traxrobotics/medicine-bottle-monitor/docs/rev2_board_back.jpg

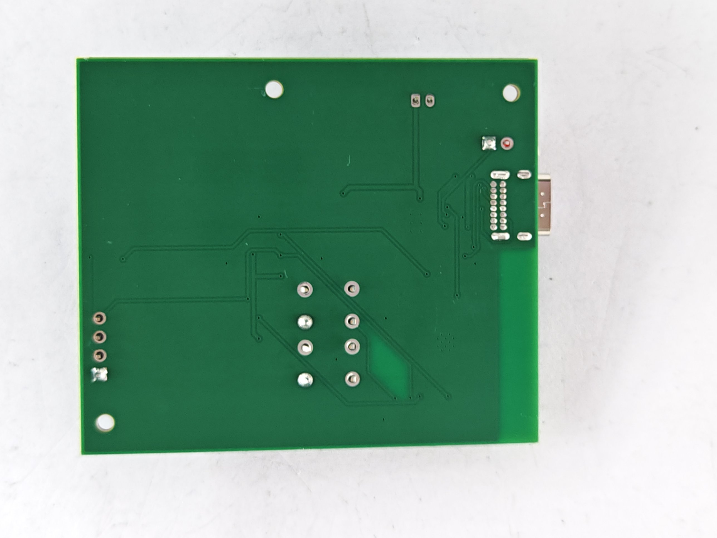
docs/rev2_board_back.jpg
