traxrobotics/medicine-bottle-monitor/hardware/bom/MedicineStorage_BOM.csv

Designator | Qty | Value | Footprint | LCSC | Description | MPN | # | Manufacturer
BT2 | 1 | CR1220 holder | Battery:BatteryHolder_Keystone_3000_1x12mm |  | Single-cell battery |  | 1
C1-C2 | 2 | 10uF, 16V, X5R | Capacitor_SMD:C_0805_2012Metric |  | Unpolarized capacitor |  | 2
C3 | 1 | 1uF, 16V, X7R | Capacitor_SMD:C_0805_2012Metric |  | Unpolarized capacitor |  | 3
C4-C5-C6-C7 | 4 | 0.1uF, 16V, X7R | Capacitor_SMD:C_0805_2012Metric |  | Unpolarized capacitor |  | 4
C8 | 1 | 10uF, 16V, X5R | Capacitor_SMD:C_0805_2012Metric |  | TP4056 VCC input cap |  | 5
C9 | 1 | 1uF, 16V, X7R | Capacitor_SMD:C_0805_2012Metric |  | EN RC delay cap |  | 6
C10 | 1 | 0.1uF, 16V, X7R | Capacitor_SMD:C_0805_2012Metric |  | DW01A VCC filter cap |  | 7
C11 | 1 | 0.1uF, 16V, X7R | Capacitor_SMD:C_0805_2012Metric |  | DRV5032 VCC decoupling |  | 8
C12 | 1 | 1uF, 16V, X7R | Capacitor_SMD:C_0805_2012Metric |  | AP2112K input cap on VSYS |  | 9
C13 | 1 | 1uF, 16V, X7R | Capacitor_SMD:C_0805_2012Metric |  | ADXL343 VS decoupling (place at pin 6) |  | 10
D1 | 1 | LED (CHRG) | LED_THT:LED_D5.0mm |  | Light emitting diode |  | 11
D2 | 1 | SS14 | Diode_SMD:D_SMA |  | Schottky, VBUS to system rail |  | 12
H1-H2-H3 | 3 | M2 hole | MountingHole:MountingHole_2.2mm_M2 |  | M2 mounting hole, 2.2 mm |  | 13
J1 | 1 | USB-C 2.0 | Connector_USB:USB_C_Receptacle_GCT_USB4085 |  | USB 2.0-only 16P Type-C Receptacle connector |  | 14
J2 | 1 | LiPo 1S | Connector_JST:JST_PH_B2B-PH-K_1x02_P2.00mm_Vertical |  | Generic connector, single row, 01x02, script generated (kicad-library-utils/schlib/autogen/connector/) |  | 15
J4 | 1 | OLED SSD1306 | Connector_PinSocket_2.54mm:PinSocket_1x04_P2.54mm_Vertical |  | Generic connector, single row, 01x04, script generated (kicad-library-utils/schlib/autogen/connector/) |  | 16
Q1-Q2 | 2 | AO3400A | Package_TO_SOT_SMD:SOT-23 |  | 30V N-channel MOSFET, logic level | 8205A or DMC2400U | 17
Q3 | 1 | AO3401A | Package_TO_SOT_SMD:SOT-23 |  | P-channel MOSFET, load sharing switch |  | 18
R1-R2 | 2 | 5.1k | Resistor_SMD:R_0805_2012Metric |  | Resistor |  | 19
R3 | 1 | 330 | Resistor_SMD:R_0805_2012Metric |  | Resistor |  | 20
R5 | 1 | 4.02k 1% | Resistor_SMD:R_0805_2012Metric |  | Resistor |  | 21
R6-R7 | 2 | 4.7k | Resistor_SMD:R_0805_2012Metric |  | Resistor |  | 22
R8 | 1 | 1k | Resistor_SMD:R_0805_2012Metric |  | Resistor |  | 23
R10 | 1 | 10k | Resistor_SMD:R_0805_2012Metric |  | Resistor |  | 24
R11 | 1 | 100 | Resistor_SMD:R_0805_2012Metric |  | DW01A VCC filter resistor |  | 25
R12 | 1 | 22 | Resistor_SMD:R_0805_2012Metric |  | USB D- series resistor |  | 26
R13 | 1 | 22 | Resistor_SMD:R_0805_2012Metric |  | USB D+ series resistor |  | 27
R14 | 1 | 10k | Resistor_SMD:R_0805_2012Metric |  | GPIO9 pull-up |  | 28
R15 | 1 | 10k | Resistor_SMD:R_0805_2012Metric |  | GPIO2 pull-up |  | 29
R16 | 1 | 10k | Resistor_SMD:R_0805_2012Metric |  | Q3 gate pull-down / VBUS discharge |  | 30
R17 | 1 | 10k | Resistor_SMD:R_0805_2012Metric |  | DS3231 INT/SQW pull-up (open drain) |  | 31
SW2 | 1 | BOOT | Button_Switch_THT:SW_PUSH_6mm_H4.3mm |  | Push button switch, generic, two pins |  | 32
SW3 | 1 | RESET | Button_Switch_THT:SW_PUSH_6mm_H4.3mm |  | Push button switch, generic, two pins |  | 33
U2 | 1 | DS3231SN | Package_SO:SOIC-16W_7.5x10.3mm_P1.27mm |  | Extremely Accurate I2C-Integrated RTC/TCXO/Crystal SOIC-16 | DS3231MZ+ | 34
U3 | 1 | 24LC256 | Package_SO:SOIC-8_3.9x4.9mm_P1.27mm |  | I2C Serial EEPROM, 256Kb, DIP-8/SOIC-8/TSSOP-8/DFN-8 | 24LC256-I/SN | 35
U4 | 1 | TP4056 | Package_SO:SOIC-8-1EP_3.9x4.9mm_P1.27mm_EP2.41x3.3mm_ThermalVias |  | 1A Standalone Linear Li-ion/LiPo single-cell battery charger, 4.2V ±1% charge voltage, VCC = 4.0..8.0V, SOIC-8 (SOP-8) | TP4056-42-ESOP8-R | 36
U5 | 1 | DW01A | Package_TO_SOT_SMD:SOT-23-6 |  | Overcharge, overcurrent and overdischarge protection IC for single cell lithium-ion/polymer battery | DW01A-G | 37
U6 | 1 | ESP32-C3-WROOM-02 | RF_Module:ESP32-C3-WROOM-02 |  | 802.11 b/g/n Wi-Fi and Bluetooth 5 module, ESP32-C3 SoC, RISC-V microprocessor, On-board antenna | N4 | 38
U7 | 1 | DRV5032FA | Package_TO_SOT_SMD:SOT-23 |  | Omnipolar Hall switch, push-pull, 20 Hz, SOT-23 (DBZ) | DRV5032FCDBZR | 39
U8 | 1 | ADXL343 | Package_LGA:LGA-14_3x5mm_P0.8mm_LayoutBorder1x6y |  | 3-Axis MEMS Accelerometer, 2/4/8/16g range, I2C/SPI, LGA-14 | ADXL343BCCZ-RL | 40
U9 | 1 | AP2112K-3.3 | Package_TO_SOT_SMD:SOT-23-5 |  | 600mA low dropout linear regulator, with enable pin, 3.8V-6V input voltage range, 3.3V fixed positive output, SOT-23-5 | AP2112K-3.3TRG1 | 41
