traxrobotics/medicine-bottle-monitor/docs/Rev2_schematic.pdf

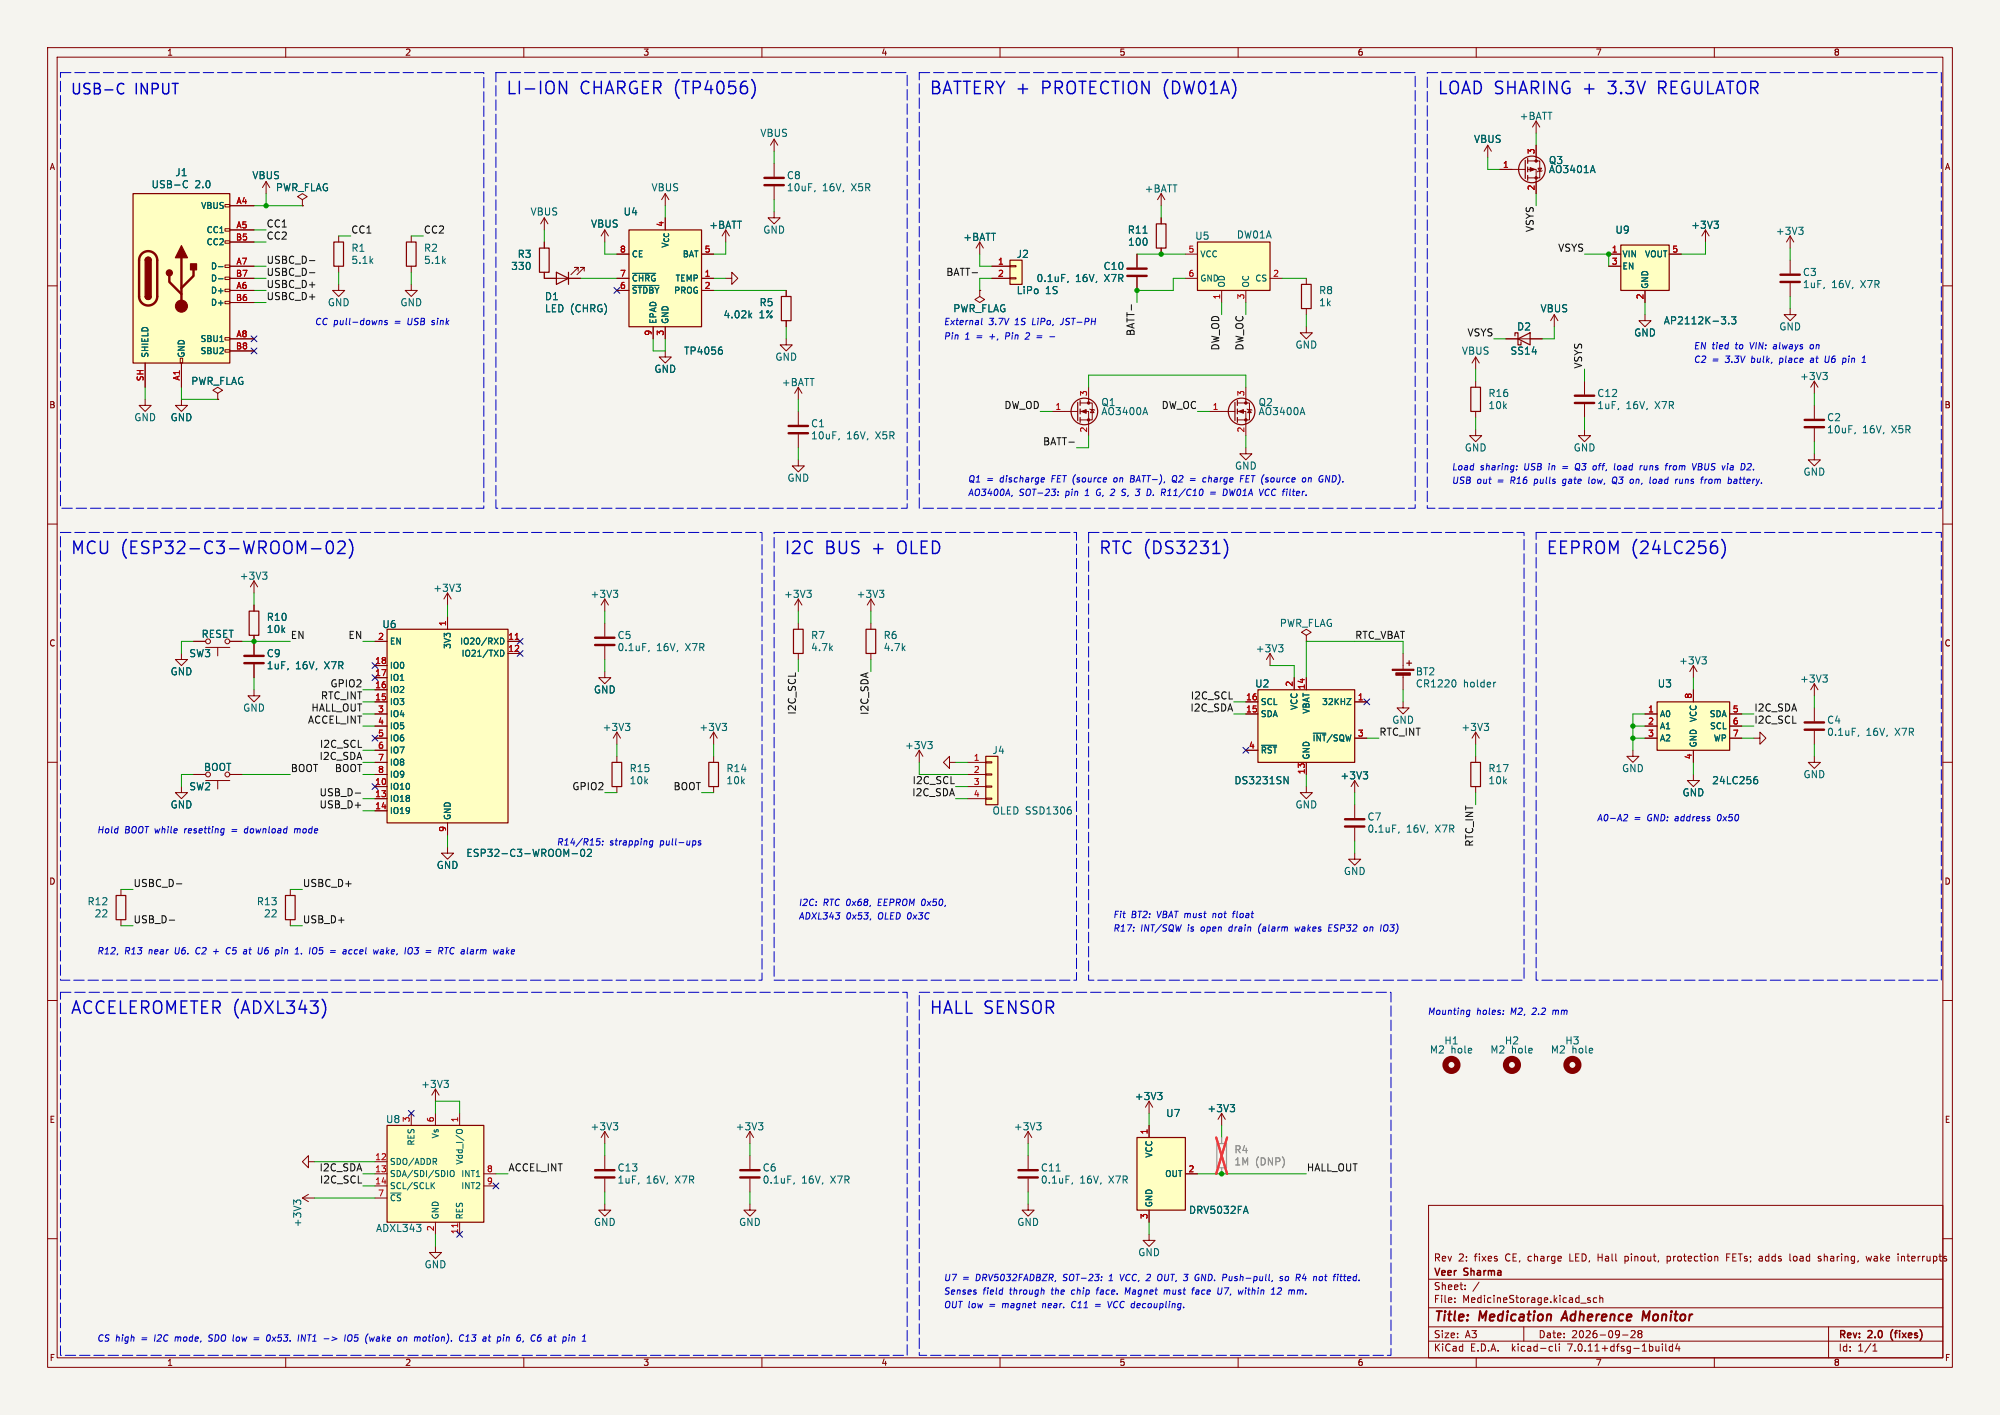
[picture p3: page 1]

C2 = 3.3V bulk, place at U6 pin 1 LOAD SHARING + 3.3V REGULATOR

3 V_{CC} 4 BAT 5 ~{STDBY} 6 ~{CHRG} 7 CE 8 EPAD

3 VCC 5 GND 6 U5 DW01A GND GND GND

PWR_FLAG
External 3.7V 1S LiPo, JST-PH

EN tied to VIN: always on R17: INT/SQW is open drain (alarm wakes ESP32 on IO3)

Load sharing: USB in = Q3 off, load runs from VBUS via D2. USB out = R16 pulls gate low, Q3 on, load runs from battery.

R12, R13 near U6. C2 + C5 at U6 pin 1. IO5 = accel wake, IO3 = RTC alarm wake

1 RES 11 SDO/ADDR 12 SDA/SDI/SDIO 13 SCL/SCLK 14 GND
