traxrobotics/medicine-bottle-monitor/hardware/kicad/MedicineStorage.kicad_pcb

## KiCad design hardware/kicad/MedicineStorage.kicad_pcb (2026-11-01)

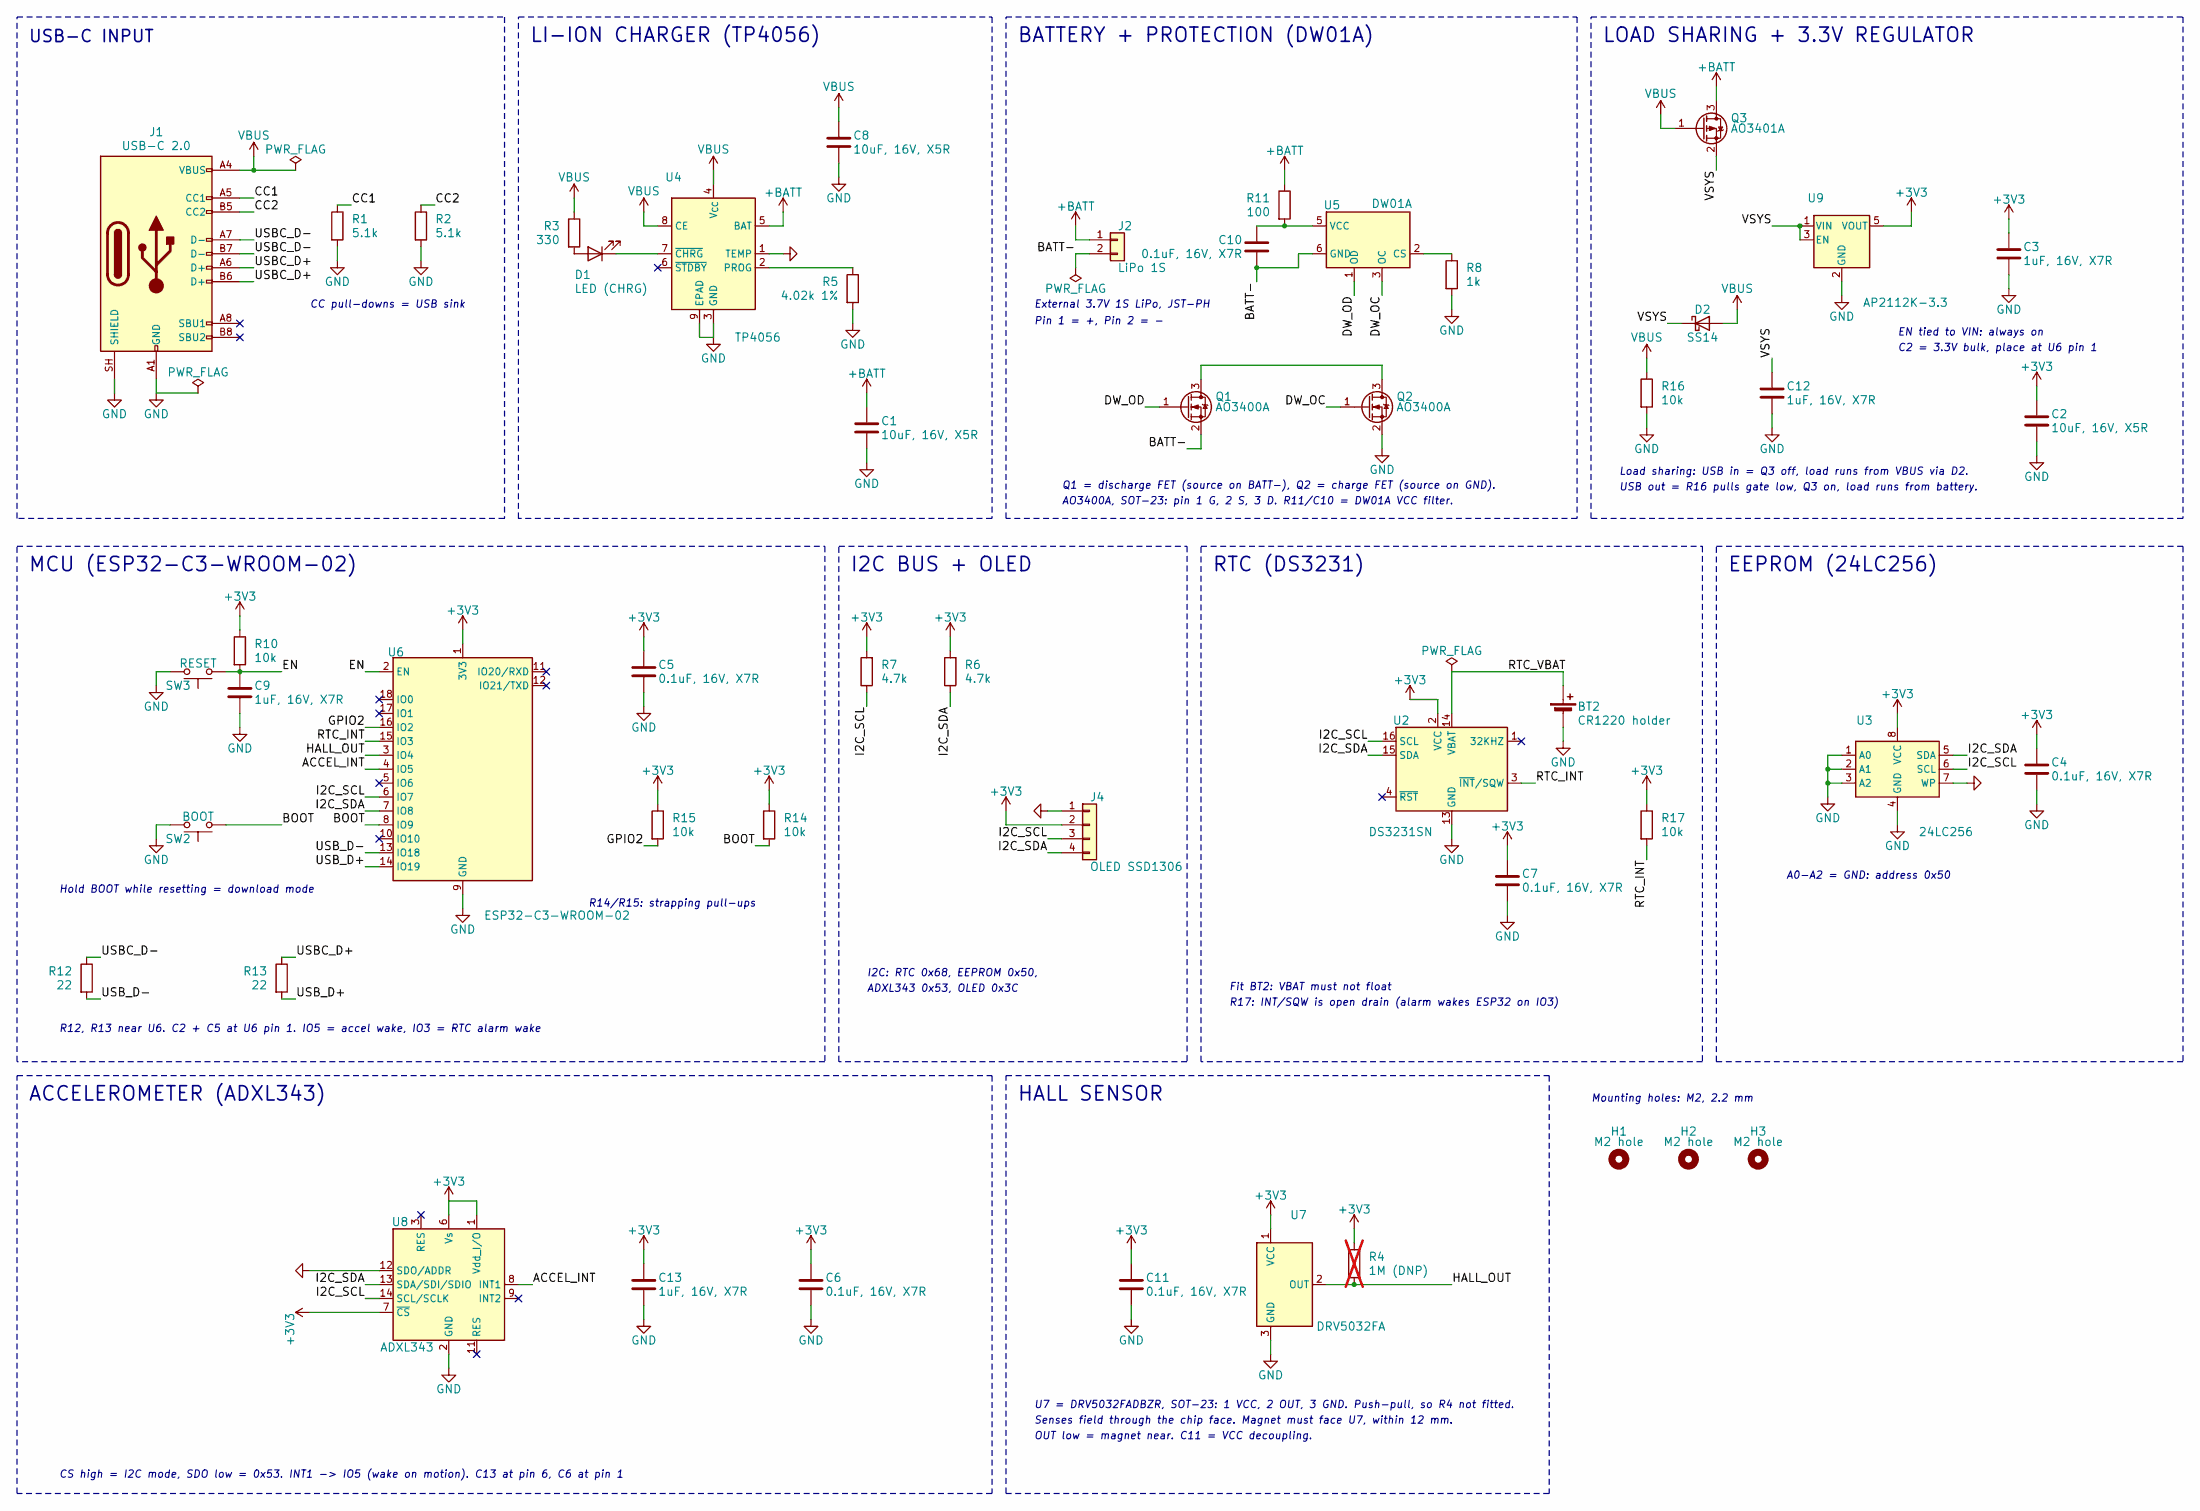
[picture p4: schematic MedicineStorage.kicad_sch, Medication Adherence Monitor]

Parts:
BT2: CR1220 holder; BatteryHolder_Keystone_3000_1x12mm; MPN Keystone 3000 (CR1220 holder, SMT) + CR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
C1, C2, C8: 10uF, 16V, X5R; C_0805_2012Metric
C3, C9, C12, C13: 1uF, 16V, X7R; C_0805_2012Metric
C4, C5, C6, C7, C10, C11: 0.1uF, 16V, X7R; C_0805_2012Metric
D1: LED (CHRG); LED_D5.0mm; MPN 5mm LED
D2: SS14; D_SMA; MPN Vishay SS14-E3/61T
H1, H2, H3: M2 hole; MountingHole_2.2mm_M2
J1: USB-C 2.0; USB_C_Receptacle_GCT_USB4085; MPN GCT USB4085-GF-A
J2: LiPo 1S; JST_PH_B2B-PH-K_1x02_P2.00mm_Vertical; MPN JST B2B-PH-K-S(LF)(SN)
J4: OLED SSD1306; PinSocket_1x04_P2.54mm_Vertical; MPN 1x4 2.54mm female header
Q1, Q2: AO3400A; SOT-23; MPN AO3400A
Q3: AO3401A; SOT-23; MPN AO3401A
R1, R2: 5.1k; R_0805_2012Metric
R3: 330; R_0805_2012Metric
R4: 1M (DNP); R_0805_2012Metric; MPN not fitted (1M 0805 only if DRV5032FC i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; not fitted
R5: 4.02k 1%; R_0805_2012Metric; MPN 4.02k 1% 0805
R6, R7: 4.7k; R_0805_2012Metric
R8: 1k; R_0805_2012Metric
R10, R14, R15, R16, R17: 10k; R_0805_2012Metric
R11: 100; R_0805_2012Metric
R12, R13: 22; R_0805_2012Metric
SW2: BOOT; SW_PUSH_6mm_H4.3mm; MPN C&K PTS645SM43-2 LFS
SW3: RESET; SW_PUSH_6mm_H4.3mm; MPN C&K PTS645SM43-2 LFS
U2: DS3231SN; SOIC-16W_7.5x10.3mm_P1.27mm; MPN DS3231SN#
U3: 24LC256; SOIC-8_3.9x4.9mm_P1.27mm; MPN 24LC256-I/SN
U4: TP4056; SOIC-8-1EP_3.9x4.9mm_P1.27mm_EP2.41x3.3mm_ThermalVias; MPN TP4056-42-ESOP8 (NanJing Top Power, LCS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
U5: DW01A; SOT-23-6; MPN DW01A-G (Fortune)
U6: ESP32-C3-WROOM-02; MPN ESP32-C3-WROOM-02-N4
U7: DRV5032FA; SOT-23; MPN DRV5032FADBZR
U8: ADXL343; LGA-14_3x5mm_P0.8mm_LayoutBorder1x6y; MPN ADXL343BCCZ
U9: AP2112K-3.3; SOT-23-5; MPN AP2112K-3.3TRG1

Connections:
+3V3: C2.1, C3.2, C4.1, C5.1, C6.2, C7.1, C11.1, C13.1, J4.2, R4.2, R6.2, R7.2, R10.1, R14.1, R15.1, R17.1, U2.2 (VCC), U3.8 (VCC), U6.1 (3V3), U7.1 (VCC), U8.1 (Vdd_I/O), U8.6 (Vs), U8.7 (~CS), U9.5 (VOUT)
+BATT: C1.2, J2.1, Q3.3 (D), R11.1, U4.5 (BAT)
/ACCEL_INT: U6.4 (IO5), U8.8 (INT1)
/BATT-: C10.2, J2.2, Q1.2 (S), U5.6 (GND)
/BOOT: R14.2, SW2.1, U6.8 (IO9)
/CC1: J1.A5 (CC1), R1.1
/CC2: J1.B5 (CC2), R2.1
/DW_OC: Q2.1 (G), U5.3 (OC)
/DW_OD: Q1.1 (G), U5.1 (OD)
/EN: C9.1, R10.2, SW3.1, U6.2 (EN)
/GPIO2: R15.2, U6.16 (IO2)
/HALL_OUT: R4.1, U6.3 (IO4), U7.2 (OUT)
/I2C_SCL: J4.3, R7.1, U2.16 (SCL), U3.6 (SCL), U6.6 (IO7), U8.14 (SCL/SCLK)
/I2C_SDA: J4.4, R6.1, U2.15 (SDA), U3.5 (SDA), U6.7 (IO8), U8.13 (SDA/SDI/SDIO)
/RTC_INT: R17.2, U2.3 (~INT/SQW), U6.15 (IO3)
/RTC_VBAT: BT2.1 (+), U2.14 (VBAT)
/USBC_D+: J1.A6 (D+), J1.B6 (D+), R13.1
/USBC_D-: J1.A7 (D-), J1.B7 (D-), R12.1
/USB_D+: R13.2, U6.14 (IO19)
/USB_D-: R12.2, U6.13 (IO18)
/VSYS: C12.1, D2.1 (K), Q3.2 (S), U9.1 (VIN), U9.3 (EN)
GND: BT2.2 (-), C1.1, C2.2, C3.1, C4.2, C5.2, C6.1, C7.2, C8.2, C9.2, C11.2, C12.2, C13.2, J1.A1 (GND), J1.A12 (GND), J1.B1 (GND), J1.B12 (GND), J1.SH (SHIELD), J4.1, Q2.2 (S), R1.2, R2.2, R5.2, R8.2, R16.2, SW2.2, SW3.2, U2.5 (GND), U2.6 (GND), U2.7 (GND), U2.8 (GND), U2.9 (GND), U2.10 (GND), U2.11 (GND), U2.12 (GND), U2.13 (GND), U3.1 (A0), U3.2 (A1), U3.3 (A2), U3.4 (GND), U3.7 (WP), U4.1 (TEMP), U4.3 (GND), U4.9 (EPAD), U6.9 (GND), U6.19 (GND), U7.3 (GND), U8.2 (GND), U8.4 (GND), U8.5 (GND), U8.12 (SDO/ADDR), U9.2 (GND)
unnamed: D1.2 (A), R3.2
unnamed: D1.1 (K), U4.7 (~CHRG)
unnamed: Q1.3 (D), Q2.3 (D)
unnamed: R5.1, U4.2 (PROG)
unnamed: R8.1, U5.2 (CS)
unnamed: C10.1, R11.2, U5.5 (VCC)
VBUS: C8.1, D2.2 (A), J1.A4 (VBUS), J1.A9 (VBUS), J1.B4 (VBUS), J1.B9 (VBUS), Q3.1 (G), R3.1, R16.1, U4.4 (V_{CC}), U4.8 (CE)

Notes on the sheet:
Q1 = discharge FET (source on BATT-), Q2 = charge FET (source on GND).
USB out = R16 pulls gate low, Q3 on, load runs from battery.
EN tied to VIN: always on
R12, R13 near U6. C2 + C5 at U6 pin 1. IO5 = accel wake, IO3 = RTC alarm wake
External 3.7V 1S LiPo, JST-PH
AO3400A, SOT-23: pin 1 G, 2 S, 3 D. R11/C10 = DW01A VCC filter.
I2C: RTC 0x68, EEPROM 0x50,
LI-ION CHARGER (TP4056)
CC pull-downs = USB sink
CS high = I2C mode, SDO low = 0x53. INT1 -> IO5 (wake on motion). C13 at pin 6, C6 at pin 1
C2 = 3.3V bulk, place at U6 pin 1
RTC (DS3231)
Senses field through the chip face. Magnet must face U7, within 12 mm.
HALL SENSOR
R14/R15: strapping pull-ups
Hold BOOT while resetting = download mode
R17: INT/SQW is open drain (alarm wakes ESP32 on IO3)
Fit BT2: VBAT must not float
EEPROM (24LC256)
LOAD SHARING + 3.3V REGULATOR
MCU (ESP32-C3-WROOM-02)
Load sharing: USB in = Q3 off, load runs from VBUS via D2.
A0-A2 = GND: address 0x50
ACCELEROMETER (ADXL343)
Pin 1 = +, Pin 2 = -
OUT low = magnet near. C11 = VCC decoupling.
USB-C INPUT
I2C BUS + OLED
Mounting holes: M2, 2.2 mm
ADXL343 0x53, OLED 0x3C
U7 = DRV5032FADBZR, SOT-23: 1 VCC, 2 OUT, 3 GND. Push-pull, so R4 not fitted.
BATTERY + PROTECTION (DW01A)

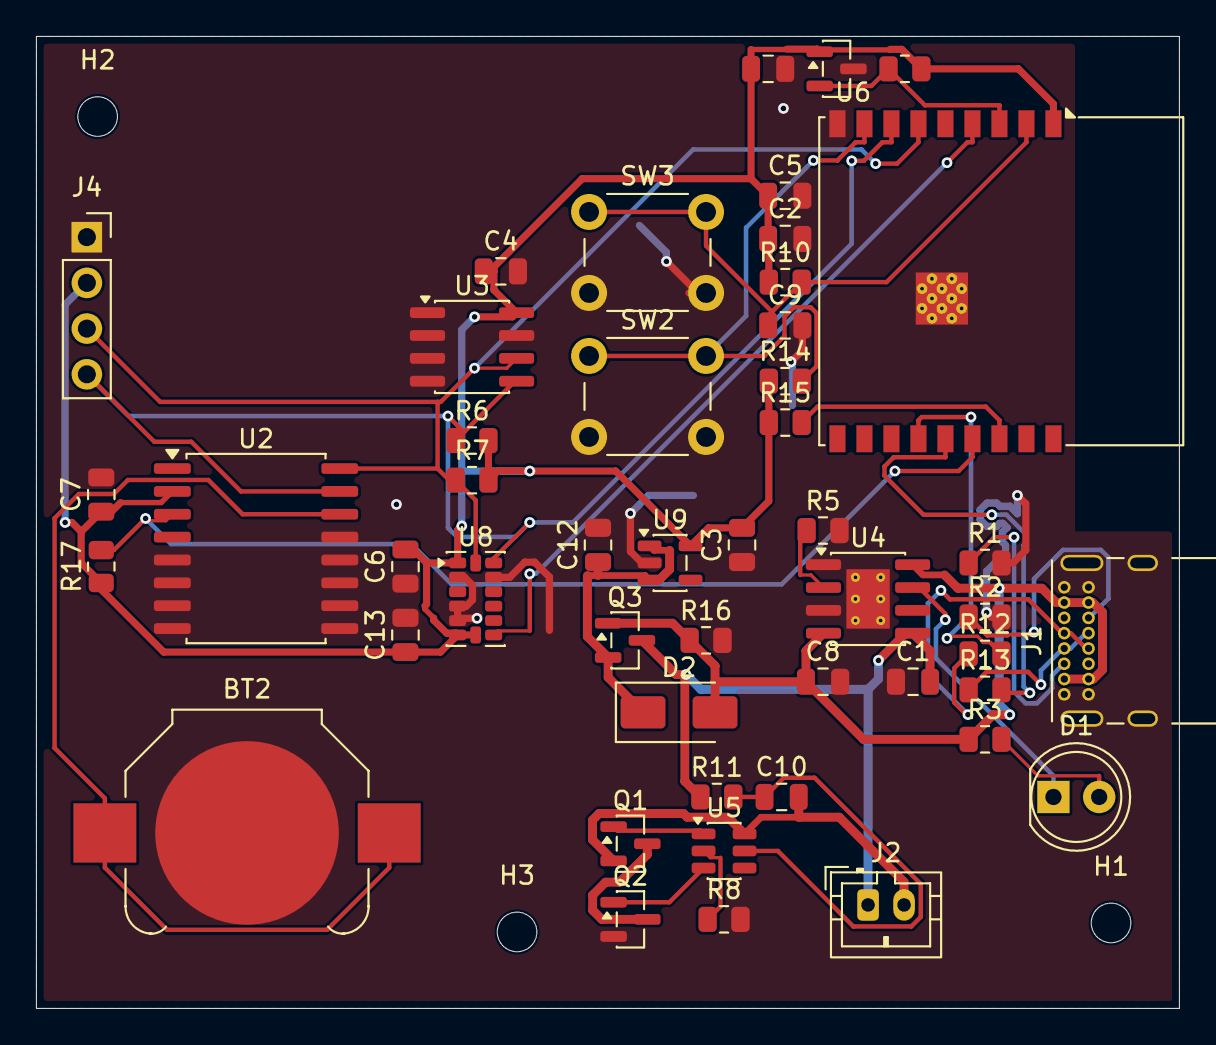
[picture p5: board MedicineStorage.kicad_pcb from above]

Board: 2 copper layers, 63.5 x 54.0 mm, 51 parts (0 on the bottom side), 29 nets.
